kk4das/Signal_Generator/KK4DAS Signal Generatorfzz_bb.png

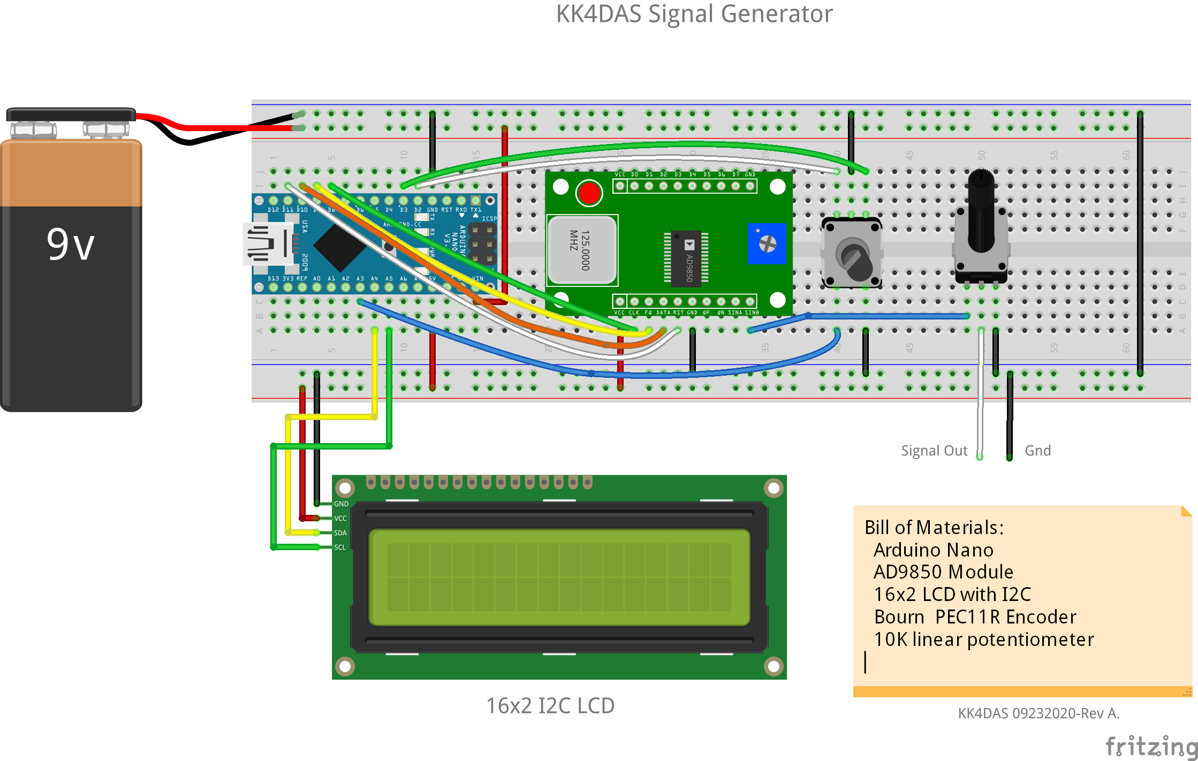
KK4DAS Signal Generatorfzz_bb.png
