kk4das/Signal_Generator/KK4DAS Signal Generatorfzz_schem.png

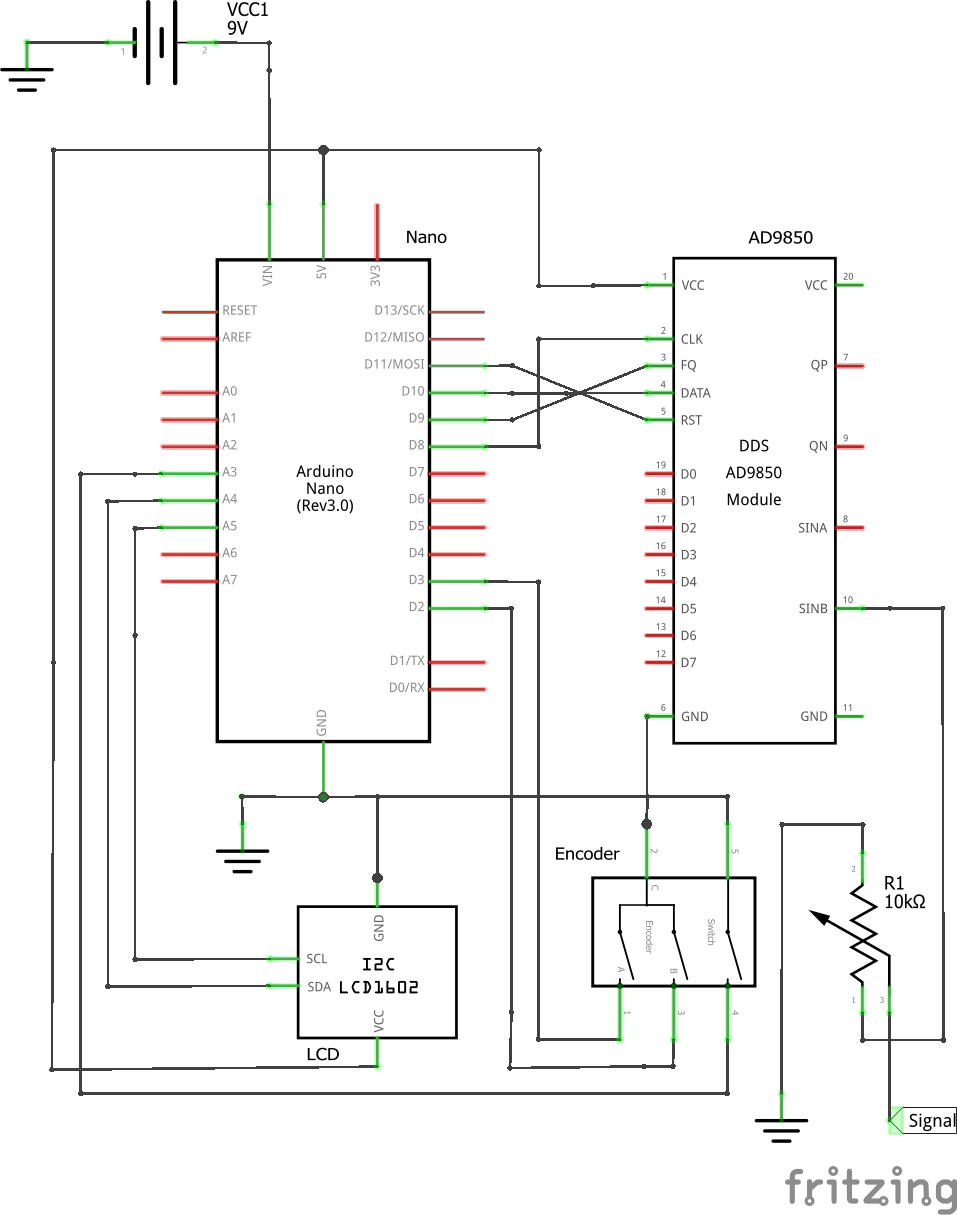
KK4DAS Signal Generatorfzz_schem.png
